lapudvan/Eclectronics_MP1/MP1.kicad_pcb

## KiCad design MP1.kicad_pcb (2019-02-11)

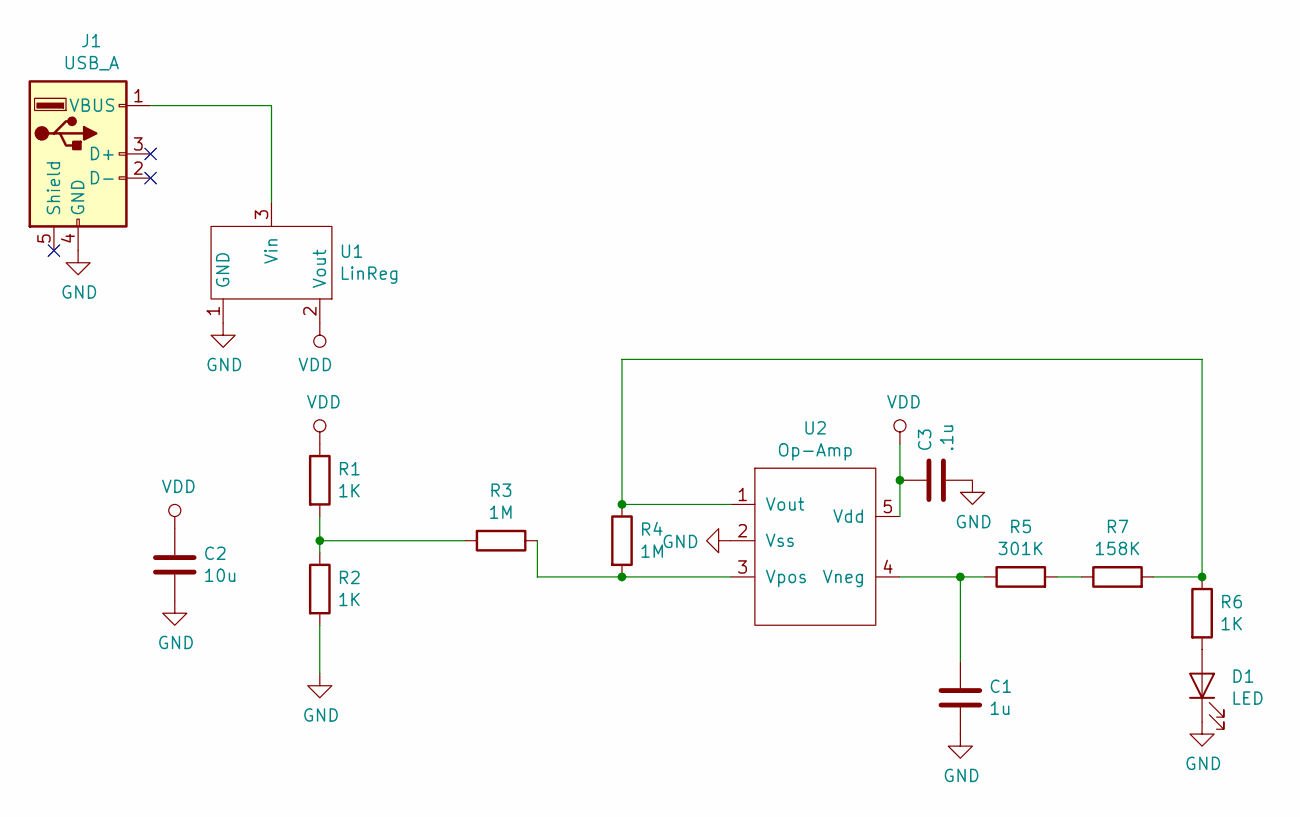
[picture p6: schematic MP1.sch]

Parts:
C1: 1u; C_0603_1608Metric
C2: 10u; C_0805_2012Metric
C3: .1u; C_0603_1608Metric
D1: LED
J1: USB_A; USB
R1, R2, R6: 1K; C_0603_1608Metric
R3, R4: 1M; C_0603_1608Metric
R5: 301K; C_0603_1608Metric
R7: 158K; C_0603_1608Metric
U1: LinReg; RegLin
U2: Op-Amp; SOT23

Connections:
GND: C1.2, C2.2, C3.2, D1.1 (K), J1.4 (GND), R2.2, U1.1 (GND), U2.2 (Vss)
unnamed: C1.1, R5.1, U2.4 (Vneg)
unnamed: D1.2 (A), R6.2
unnamed: J1.1 (VBUS), U1.3 (Vin)
unnamed: R1.2, R2.1, R3.2
unnamed: R3.1, R4.2, U2.3 (Vpos)
unnamed: R4.1, R6.1, R7.2, U2.1 (Vout)
unnamed: R5.2, R7.1
VDD: C2.1, C3.1, R1.1, U1.2 (Vout), U2.5 (Vdd)

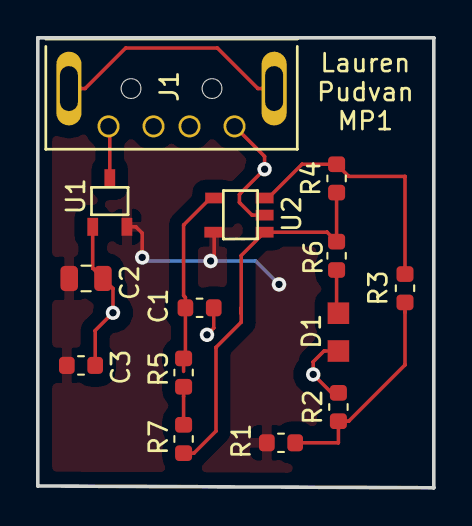
[picture p7: board MP1.kicad_pcb from above]

Board: 2 copper layers, 22.0 x 25.0 mm, 14 parts (0 on the bottom side), 9 nets.
